asifulshiam/stm32-cipher/docs/clock_configuration.png

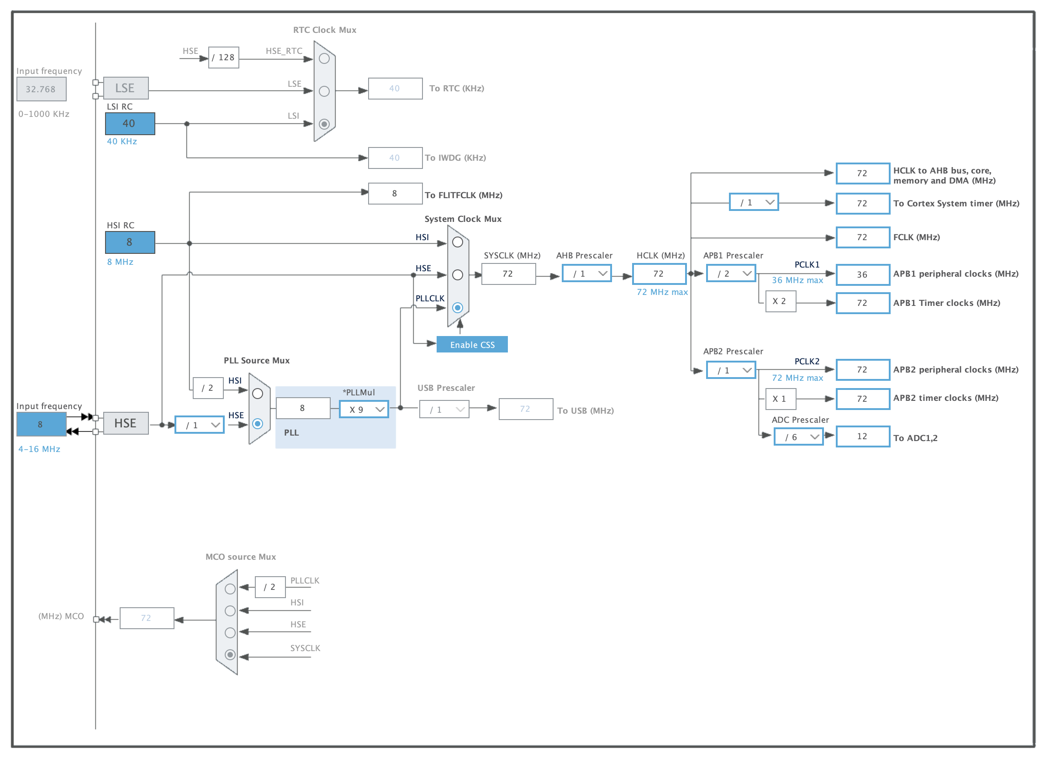
docs/clock_configuration.png
