asifulshiam/stm32-cipher/docs/pin_configuration.png

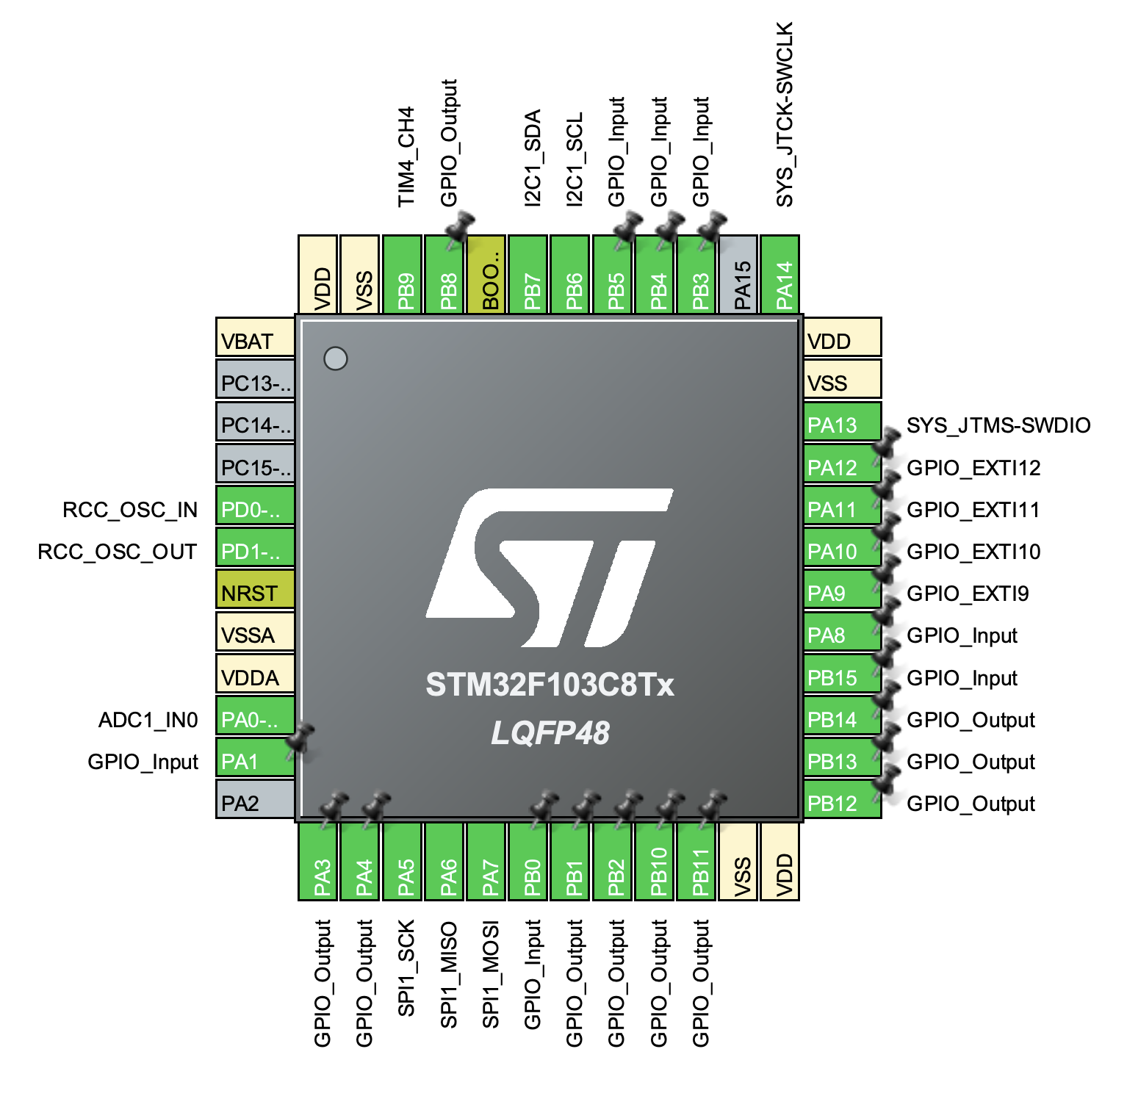
docs/pin_configuration.png
