asifulshiam/stm32-cipher/hardware_tests/hcsr04_test/pin_configuration.png

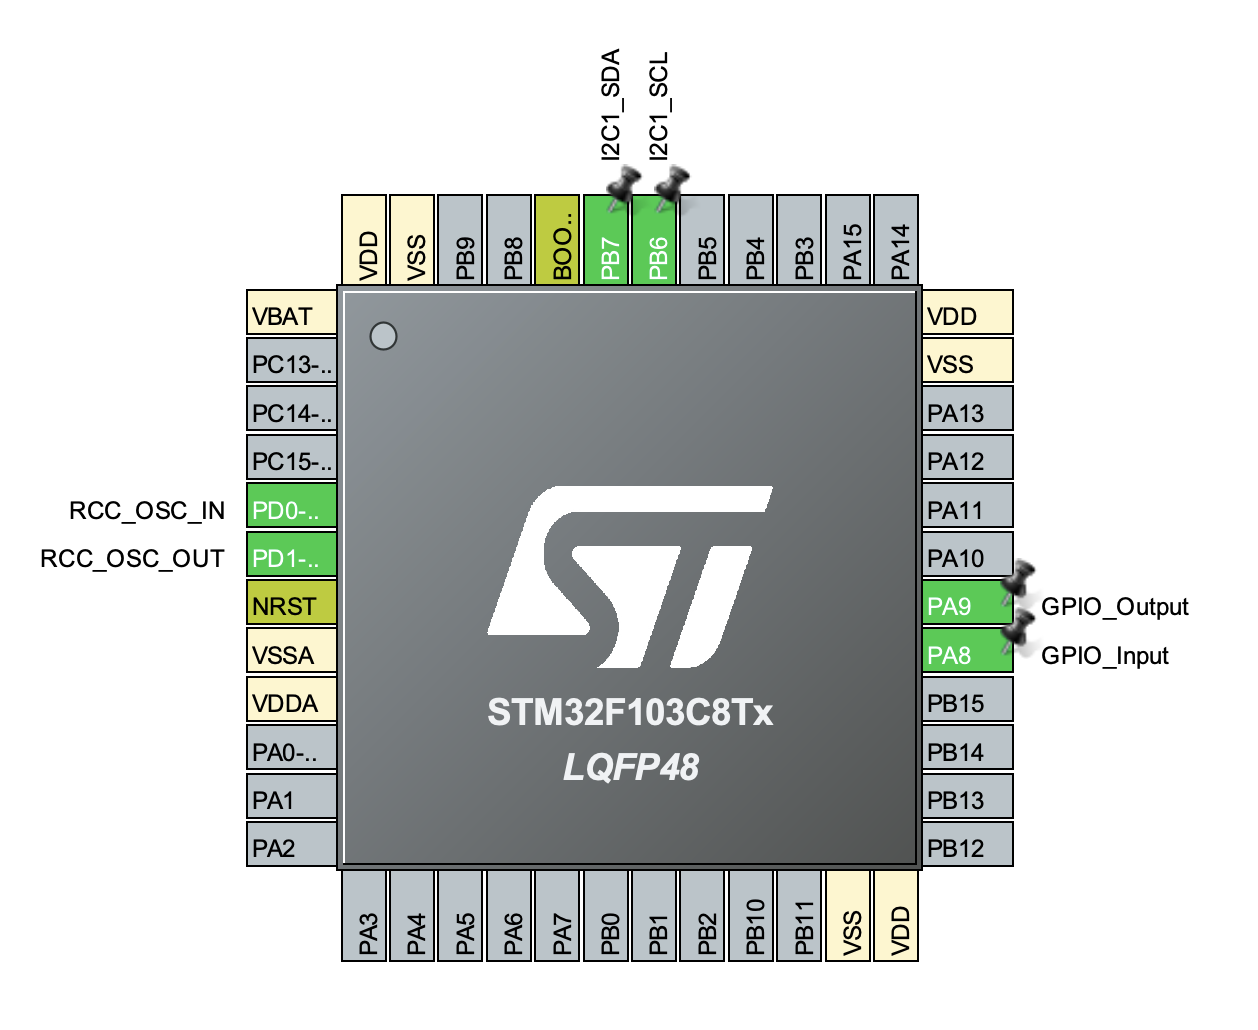
hardware_tests/hcsr04_test/pin_configuration.png
