asifulshiam/stm32-cipher/hardware_tests/oled_test/pin_configuration.png

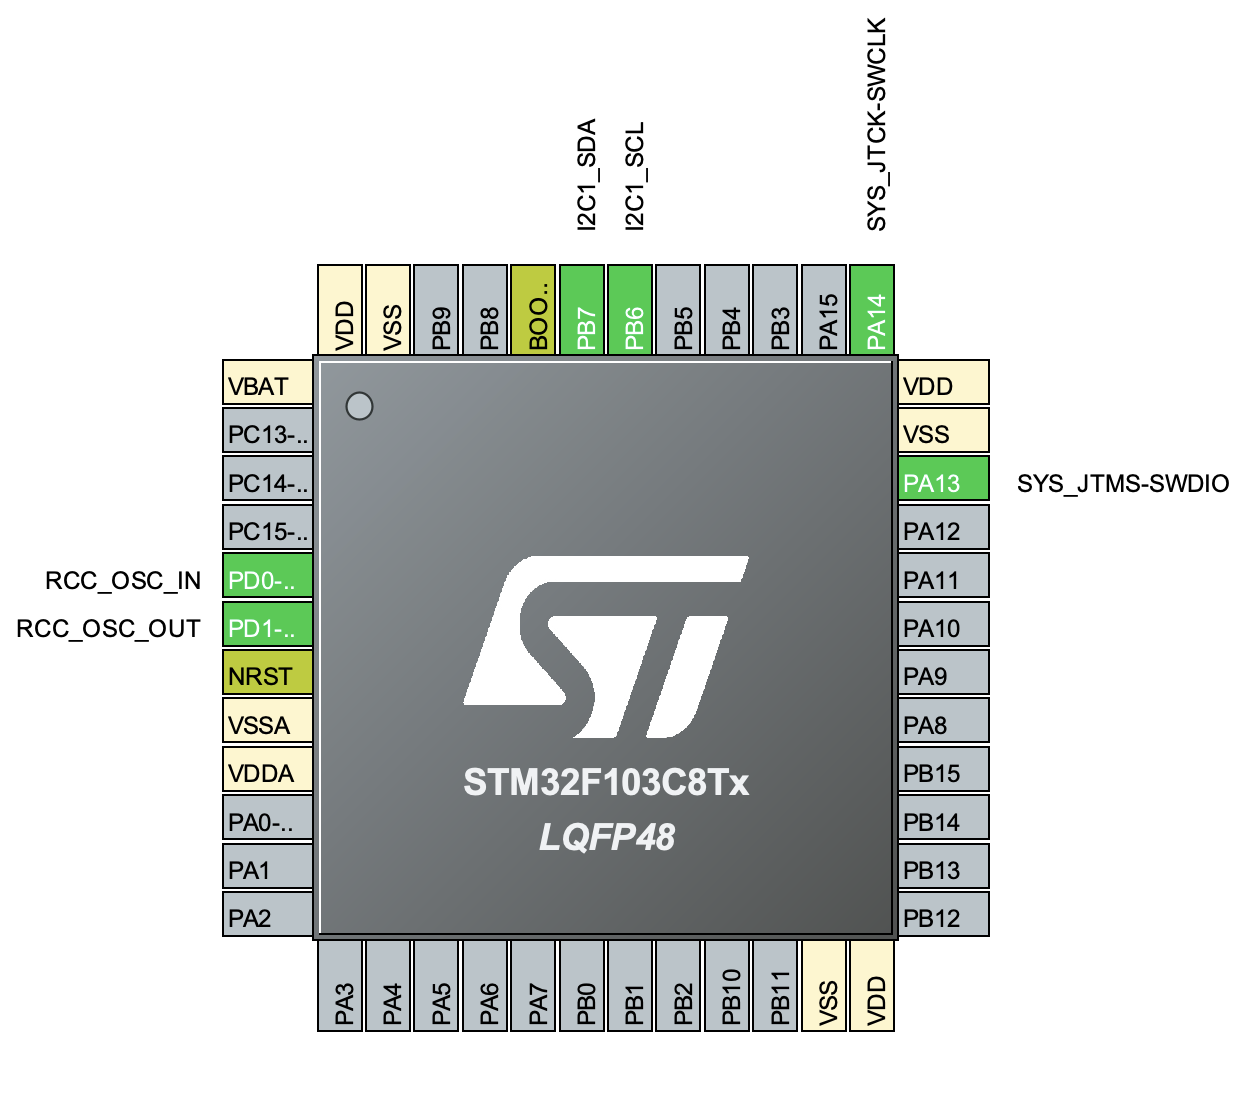
hardware_tests/oled_test/pin_configuration.png
